Badrodro/RV32I-Alpha/(commit log)

2026-10-21 Fix branch conditions, LUI/AUIPC and add byte/half-word memory access
    - Branches: reuse the ALU (SUB / SLT / SLTU) and decide with funct3, so
    BNE, BLT, BGE, BLTU and BGEU now work (only BEQ did before).
    - LUI uses 0 and AUIPC uses the PC as first ALU operand (both used rs1).
    - New Load_store_unit: LB/LH/LBU/LHU/SB/SH with byte enables on the RAM.
    - Self-checking torture test (177 instructions), ROM grown to 256 words
    and generated by asm/build_rom.py.
    - Testbench now checks the pass/fail verdict instead of only TRAP.
    - Register file initialised to zero, like the FPGA at power-up.
    [ALU_decoder.vhd, Load_store_unit.vhd, Main_decoder.vhd, RAM.vhd, Register_file.vhd, top_tb.vhd]
2026-10-21 Add build scripts, Basys 3 constraints, CI and area estimates
    - constraints/Basys3.xdc: clock, reset on BTNC, trap on LED 15,
    testOUT on the four Pmod headers.
    - scripts/vivado_build.tcl: one-command Vivado flow that regenerates
    the utilization, timing and power reports and the bitstream.
    - scripts/sim.sh + GitHub Actions: run the torture test with GHDL on
    every push.
    - Testbench stops its clock so the simulation ends by itself.
    - README: explain that the ROM contents shrink the measured area, add
    Yosys estimates (full design and core only), build instructions.
    [Basys3.xdc, top_tb.vhd]
2026-10-21 Split the core from its memories and pipeline it in two stages
    The single-cycle loop PC -> asynchronous ROM -> register file -> ALU ->
    write-back did not meet 100 MHz (WNS -2.741 ns in Vivado 2024.2).
    - New src/core.vhd (rv32i_core): IF/EX pipeline. The instruction
    memory is synchronous and its output register is the IF/EX register.
    Branches are predicted not taken; a taken branch or a jump kills one
    fetched instruction. Loads stay two cycles in EX. No forwarding is
    needed: the register file is written at the end of EX, before the
    next instruction reads it.
    - Harvard memory ports (imem / dmem) with enables, so the memories are
    only read when needed. PC + 4 for JAL/JALR comes fro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
2026-10-21 Add formal verification: riscv-formal and memory-port checks
    - formal/checks.cfg + wrapper.sv: riscv-formal on the VHDL core through
    the GHDL Yosys plugin. All 37 RV32I instructions plus the reg,
    pc_fwd, pc_bwd, causal, unique, liveness, ill and cover checks pass
    (yices, bounded model checking).
    - formal/memcheck.sv: what riscv-formal does not check.
    imem: the retired instruction is the word fetched at its PC.
    dmem: a load returns the bytes last stored at its address, through
    the real data port (catches a load that uses data from the wrong
    cycle). illegal: every non-RV32I word traps without side effects,
    checked against an independent reference decoder; FENCE is a NOP.
    - Muta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
    [checks.cfg]
2026-10-21 Add a grant input on the data port (wait states)
    dmem_gnt lets an arbiter, a slower memory or a memory-mapped
    accelerator delay a load or a store: the request is held until it is
    granted, and read data is used one cycle after the grant. The Basys 3
    top ties it to '1', so it costs nothing there.
    Formal: dmem_gnt is left free in both harnesses, so every wait-state
    pattern is covered; liveness assumes at most two wait cycles in a row.
    New property: a request that was not granted is repeated unchanged.
    [checks.cfg]
2026-10-21 Shrink the ALU and take equality off the adder path
    - One 33-bit adder for ADD, SUB, SLT, SLTU and the branch comparisons:
    with sign- or zero-extended operands, bit 32 of a - b is a < b. The
    carry-in comes from an extra low bit, so it stays a single adder.
    - One right shifter for SRL, SRA and SLL (SLL = reverse, shift right,
    reverse).
    - Equality is compared on the operands, in parallel with the adder,
    instead of testing the adder output for zero.
    - The ALU takes funct3 directly; the ALU decoder only remaps loads,
    stores, LUI, JALR and branches.
    - AUIPC uses the jump target adder (PC + imm); the first ALU operand is
    now rs1 or zero only.
    - scripts/synth_report.sh: Yosys area for X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
    [ALU.vhd, ALU_decoder.vhd, Main_decoder.vhd, core.vhd]
2026-10-24 Compute imem_en from the decoder only
    imem_en no longer depends on trapNow (ALU and branch comparison): it
    is low whenever a load or store is waiting, which covers every stall.
    A trapping instruction may fetch one useless word before the core
    halts. This makes the enable available early in the cycle, so an ASIC
    SRAM can capture it on the falling clock edge.
    riscv-formal + memory-port checks: 48/48 pass.
    [core.vhd]
2026-10-24 Add a SystemVerilog version of the core, proven equivalent to the VHDL
    rtl/core/ holds the same two-stage core in SystemVerilog (decoder, ALU,
    load/store unit, register file, core). formal/equiv_vhdl_sv.sh proves
    it sequentially equivalent to src/ with Yosys (equiv_make,
    equiv_simple, equiv_induct): 1826 of 1826 cells proven, RVFI outputs
    included. The proof runs in CI after the riscv-formal checks.
2026-10-24 Add a SKY130 place-and-route flow for the core
    asic/core_syn.tcl synthesizes the SystemVerilog core on
    sky130_fd_sc_hd (typical corner): 4696 cells, 59557 um2, the register
    file being 992 flip-flops. asic/core_pnr.tcl places and routes it with
    OpenROAD: 375.8 um square die, 47 % utilization, 234 mm of wire, no
    violations from the detailed router. No power grid, clock tree or
    timing closure yet. asic/defplot.py draws the placement and the wires
    from the routed DEF (assets/rv32i_sky130_layout.png).
    scripts/synth_report.sh: say that its pre-layout path (no buffering,
    no resizing) is not a clock frequency.
    [defplot.py]
2026-10-24 Update the README and the architecture diagram for the two-stage core
    The README described the first, single-cycle version. It now covers
    the two-stage pipeline, the cycle counts, every formal check with its
    depth, the equivalence proof, the SKY130 results and their limits, and
    says which Vivado reports are from the first version. The diagram shows
    pc_if / pc_ex, the memories outside the core, the shared target adder,
    the data-port grant and the pipeline control.
2026-10-24 Vivado 2024.2 results for the current version
    reports/: utilization and timing of the core alone (out of context) and
    utilization, timing and power of the Basys 3 build.
    - Core alone: 675 LUTs (44 as distributed RAM for the register file),
    63 flip-flops, 100 MHz met (worst slack +0.111 ns).
    - Board build: 751 LUTs, 127 flip-flops, 1 BRAM, 100 MHz not met
    (worst slack -0.538 ns, path from the ROM output register through the
    register file and the address computation to the data BRAM write
    enable), about 95 MHz.
    ROM.vhd: the ROM is built from LUTs, not from a BRAM; fix the comment.
2026-10-24 Register file (SystemVerilog): no storage for x0
    regs is declared [1:31]: x0 reads as zero and is never written, so it
    needs no flip-flops. LibreLane's synthesis kept 31 dead x0 flip-flops
    with the [0:31] array; the macro now has 992 register-file flip-flops.
    The VHDL version keeps 32 entries (distributed RAM on the FPGA).
    formal/equiv_vhdl_sv.sh: equivalence proven, 1794 of 1794 cells.
    [rv32i_regfile.sv]
2026-10-24 Harden the core to GDSII with LibreLane (sky130)
    asic/config.json and asic/rv32i_alpha_macro.sv run the full LibreLane
    flow on the core: power grid, placement, clock tree, timing repair,
    routing, parasitic extraction and sign-off.
    - Die 466.9 x 477.6 um (0.223 mm2), 13350 standard cells, 54 %
    utilization, 527 mm of wire.
    - DRC clean (Magic, KLayout), LVS clean (Netgen), no antenna violation.
    - 40 MHz: setup met at the typical (+4.24 ns) and fast corners, not
    met at the slow corner (-4.85 ns); hold met at every corner.
    - 5.9 mW at 40 MHz, typical corner, default switching activity.
    asic/defplot.py now also draws the power grid and finds the register
    file from its net names. The quick Op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
2026-10-24 Run the riscv-tests rv32ui suite: 40 tests pass
    tests/rv32ui/: a minimal test environment (no CSRs: a test ends with
    ECALL and leaves its result in gp), a testbench with one memory behind
    both ports and random data-port grants, and run.sh, which fetches
    riscv-tests at a fixed commit, builds the tests with clang and lld and
    runs them on the SystemVerilog core with Icarus Verilog.
    40 of the 42 rv32ui tests pass. fence_i (self-modifying code) and
    ma_data (misaligned accesses, trapped by design) are skipped; ma_data
    fails as expected, which also checks that the testbench reports
    failures. New CI job.
    README: the core is built for the Basys 3; the bitstream has not been
    tested on a board yet.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
    [tb_rv32ui.sv]
